bbc/dvbcss-synctiming/hardware/partslist.rst

Parts list for prototype circuit
================================

Arduino and prototype circuit parts:

+-----+-------------------------------------+------------------------------------------------------------------------------------+
| Qty | Description                         | Ordering info                                                                      |
+=====+=====================================+====================================================================================+
|  1  | Arduino Due (32bit ARM based)       | RS-Online 7697412 "Arduino Due 32bit ARM Cortex-M3 module"                         |
+-----+-------------------------------------+------------------------------------------------------------------------------------+
|  2  | PCB Mount 3.5mm jack socket         | Farnell 1608405 "SWITCHCRAFT  35RAPC4BHN2  CONNECTOR, RCA, JACK, 3.5MM, THT, 5WAY" |
+-----+-------------------------------------+------------------------------------------------------------------------------------+
|  2  | TSL252R Photodiode sensor           | Farnell 1182348 "AMS  TSL252R-LF  PHOTODIODE, SENSOR, L/VOLTS"                     |
+-----+-------------------------------------+------------------------------------------------------------------------------------+
|  1  | Arduino shield prototyping kit      | Farnell 2285199 "ARDUINO  A000081  PROTOTYPE KIT, ARDUINO MEGA, REV 3"             |
+-----+-------------------------------------+------------------------------------------------------------------------------------+
|  4  | 100K resistor                       | any suitable                                                                       |
+-----+-------------------------------------+------------------------------------------------------------------------------------+
|  2  | 15uF capacitor                      | any suitable                                                                       |
+-----+-------------------------------------+------------------------------------------------------------------------------------+
|  2  | 4.7nF capacitor                     | any suitable                                                                       |
+-----+-------------------------------------+------------------------------------------------------------------------------------+

Connectors and cable assembly parts for a flying lead to the TSL252 photodiode:

+-----+-------------------------------------+------------------------------------------------------------------------------------------------------------------+
| Qty | Description                         | Ordering info                                                                                                    |
+=====+=====================================+==================================================================================================================+
|   6 | Solderless terminal crimps          | Farnell 7356145 "JST (JAPAN SOLDERLESS TERMINALS)  BXA-001T-P0.6  CONTACT, CRIMP, RECEPTACLE, 28-22AWG"          |
+-----+-------------------------------------+------------------------------------------------------------------------------------------------------------------+
|   2 | Shrouded 3 pin header (socket)      | Farnell CN18396 "JST (JAPAN SOLDERLESS TERMINALS)  B03B-XASK-1(LF)(SN)  HEADER, SHROUDED, VERTICAL, 2.5MM, 3WAY" |
+-----+-------------------------------------+------------------------------------------------------------------------------------------------------------------+
|   2 | 3 pin connector housing (plug)      | Farnell 7356080 "JST (JAPAN SOLDERLESS TERMINALS)  XAP-03V-1  CONNECTOR HOUSING, 3WAY"                           |
+-----+-------------------------------------+------------------------------------------------------------------------------------------------------------------+
