bbc/dvbcss-synctiming/(threads)

Thread 1 (2015-03-04):

Add ability to set how long the measurement period is

matt-hammond-bbc, 2015-03-04:
Currently the measurement period is hard coded to be the amount of time it takes to fill the buffer on the Arduino.

The Arduino and PC code should be modified to allow the measurement period to be set as a command line options.

It should also sanity check that the measurement period requested (via the command line option) does not exceed the buffer space available on the Arduino, and generate an error if it does.

matt-hammond-bbc, 2015-05-22:
Completed and merged

Closed 2015-05-22.

Thread 2 (2015-03-04):

Add ability to measure TV Device

matt-hammond-bbc, 2015-03-04:
Currently the code only measures a CSA. Need to write a version (e.g. `src/exampleTvTester.py`) that will work in the opposite role - pretending to be a CSA and measuring the timing accuracy of the TV Device it connects to.

matt-hammond-bbc, 2015-03-04:
Work was begun in "dev-tv-tester" branch.
Branch should be considered unstable.

matt-hammond-bbc, 2015-03-20:
Work completed and merged. Part of 0.2 release.

Closed 2015-03-20.

Thread 6 (2016-09-05):

Non integer framerates

benroeder, 2016-09-05:
Do you have any plans to support generation of non integer framerates such as
NTSC (30/1.001) or the 23.976/23.98 Film'ish ones ?

matt-hammond-bbc, 2016-09-06:
Looking at the command line arguments, it looks like you can already specify a non integer tick rate for a timeline. (see [lines 92 and 93 of `src/testsetupcmdline.py`](https://github.com/bbc/dvbcss-synctiming/blob/master/src/testsetupcmdline.py#L92)).

Have you found any part of the project where it is not possible to specify the require frame rate?

benroeder, 2016-09-06:
Sorry I did not make my self clear, the generation of test material, is what I was after.
https://github.com/bbc/dvbcss-synctiming/blob/master/test_sequence_gen/src/generate.py#L175 see test_sequence_gen/src/generate.py line 175
which relies on https://github.com/bbc/dvbcss-synctiming/blob/master/test_sequence_gen/src/generate.py#L67 line 67

matt-hammond-bbc, 2016-09-06:
Ah, I understand.
To avoid a massive rewrite in can probably be hacked in relatively easily by adding a "x1.001" command line option:

* To select a suitable "pattern", then picking the numerically closest from that existing list is probably acceptable.
* The image drawing code could then simply pretend, for the purposes of generating video frames, that it is running at the integer rate. Might need to suppress generating a "hh:mm:ss:ff" graphic to avoid being misleading.
* The audio rendering code would need to pretend it is running at a slightly faster sampling rate (x1.001) when calculating where to begin and end each beep.
* The timings and fps saved into the metadata file would need scaling by x1.001

I don't personally plan to make the changes, but contributions are very welcome.

Thread 7 (2017-06-03):

Hardware Ref

algo1980, 2017-06-03:
Hi,
Can someone suggest me a a dvbc hardware solution.
thanks

matt-hammond-bbc, 2017-06-08:
Hello,

I don't fully understand the question. This project's hardware and software should work for any system that implements the DVB CSS protocols.

kind regards

Matt

algo1980, 2017-06-09:
Hi matt,
regards for your reply. But what hardware do you suggest firmware should be built upon. If aiming for 4k. In addition it have to be cost effective too. I have been looking into some chips from st and broadcoam, but a little confused.

matt-hammond-bbc, 2017-06-12:
The [README](https://github.com/bbc/dvbcss-synctiming/blob/master/hardware/README.md) in the [/hardware](https://github.com/bbc/dvbcss-synctiming/tree/master/hardware) subdirectory of this project gives full details of what hardware is needed to build the calibration/measurement system. This is resolution independent and is not based around a TV or STB chipset.

Is your question actually about implementation of DVB CSS / HbbTV 2 in a TV/STB? This is technically outside the scope of this github project, however you are welcome to contact me directly be email (see bottom of [README](https://github.com/bbc/dvbcss-synctiming/blob/master/README.md)).

algo1980, 2017-06-12:
hi matt this is a very basic and far away from what i am wanting for this project. I wonder if arduini due is capable of delivering good results. I am going through the read me but cant see a way to contact you matt.
Regards.

matt-hammond-bbc, 2017-06-13:
Hello. Contact details are at the bottom of the main README. See the heading "Contact and discuss".

Regarding the suitability of the arduino: we have built and used this system and can therefore confirm from experience that it works. In practice we have been able to make measurements that are accurate to within a few milliseconds.

algo1980, 2017-06-17:
I can't find contact link in read me.
Can u please send me the link.

Thank you

matt-hammond-bbc, 2017-06-17:
The email addresses are not provided as links. This is done to avoid spam. The names of the "original authors" near the end of the [README](https://github.com/bbc/dvbcss-synctiming/blob/master/README.md) can be translated into email addresses.

algo1980, 2017-07-21:
invain i tried to contact but no replies from the admins.

matt-hammond-bbc, 2017-07-21:
I don't understand - nobody in this project is identified as an admin.

Matt 'dot' Hammond 'at' bbc.co.uk

matt-hammond-bbc, 2018-08-01:
Closing this issue as the conversation appears to have ended

Closed 2018-08-01.

Thread 8 (2017-08-09):

create_test_video fails if pillow version is greater 4.1

mprobst-irt, 2017-08-09:
I tried to set up the tool on Ubuntu 16.04

When generating the test content, without changing the script, it fails Generating the video.

Problem is the version of pillow, which was 4.2, downgrading to 4.1 is a workaround.

See also here
https://github.com/python-pillow/Pillow/issues/2614

The stacktrace of the error is:

`Generating video images...
Traceback (most recent call last):
  File "./src/generate.py", line 424, in <module>
    for frame in frames:
  File "/home/dvbcss/sync_accurcy_test/dvbcss-synctiming/test_sequence_gen/src/video.py", line 321, in genFrameImages
    w,h = font.getsize(text)
  File "/usr/local/lib/python2.7/dist-packages/PIL/ImageFont.py", line 156, in getsize
    size, offset = self.font.getsize(text, direction, features)
SystemError: error return without exception set
Error during creation of wav/png/metadata. Aborting`

hugovk, 2017-10-04:
Good news, https://github.com/python-pillow/Pillow/issues/2614 has been fixed in this week's Pillow 4.3.0 release.

`pip install -U pillow` should sort it for you.
