bbc/dvbcss-synctiming/hardware/circuit.pdf

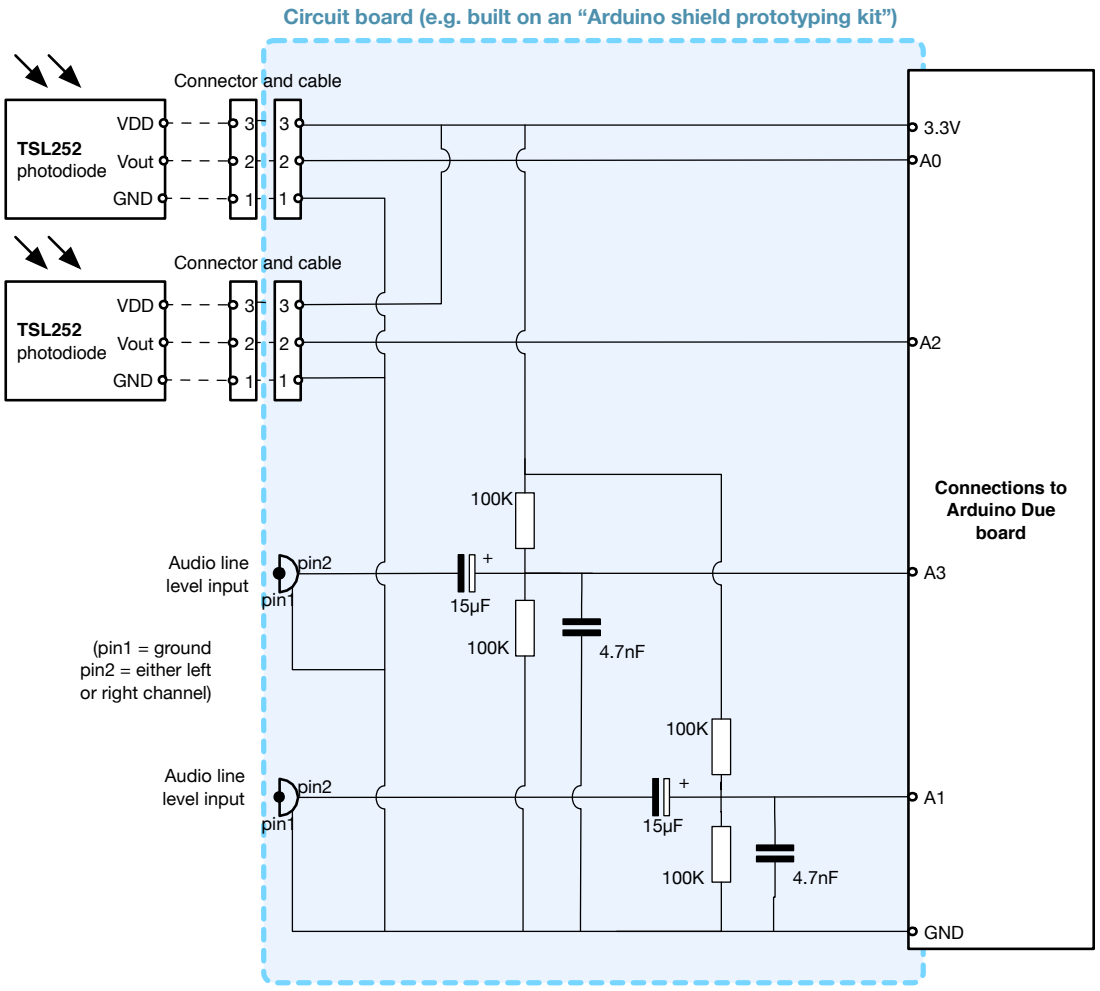
[picture p10: page 1]
Audio line level input; Connections to Arduino Due board; GND; pin2; pin1; TSL252 photodiode

Circuit board (e.g. built on an “Arduino shield prototyping kit”)

Connector and cable
VDD
Vout
GND

(pin1 = ground
pin2 = either left
or right channel)
