bbc/dvbcss-synctiming/(commit log)

2015-03-04 Partially tested change to how wallclock->sync.timeline correlations are handled.
    Generalised the algorithm to allow any arbitrary sequence of correlations to
    be recorded (e.g. control timestamps arriving from a TV Device) and then use
    those to reconstruct the timeline (old code assumed you only provided a pair
    corresponding to one before and one after the measurement period).
2015-03-04 Bugfix in interpolation, plus unittests to cover it.
    [detect.py]
2015-03-05 add first cut of the master TV tester.
2015-03-05 fix cmd arg related problems.
    [exampleTVTester.py, measurer.py]
2015-03-05 Updated docs for mode of measuring a TV Device
2015-03-09 Removed side-effects from printTestSetup() and bugfix undeclared WAIT_SECS
    [testsetupcmdline.py]
2015-03-09 Make help text correct for both CSA and TV testing.
    [testsetupcmdline.py]
2015-03-09 Removed debug print statements
2015-03-09 Corrected cmd line arg order and made README consistent
    [testsetupcmdline.py]
2015-07-10 Corrected detection of video encoder to pick only one when both possibilities are installed.
2015-07-15 Fixed instructions: missing Arduino drivers
2015-07-16 Bugfix: should have been a list of tokens
    [exampleCsaTester.py]
2015-07-21 Added ability to control what combination of audio, frames and metadata is generated
2015-08-10 Fixed bug. Was not indexing correctly into channels. Simplified by keeping as an array of 4 entries until after capture when it is fed into the detection code
    [measurer.py]
